perdidor/Arduino-MDB-UART/PCB/Full Schematics.png

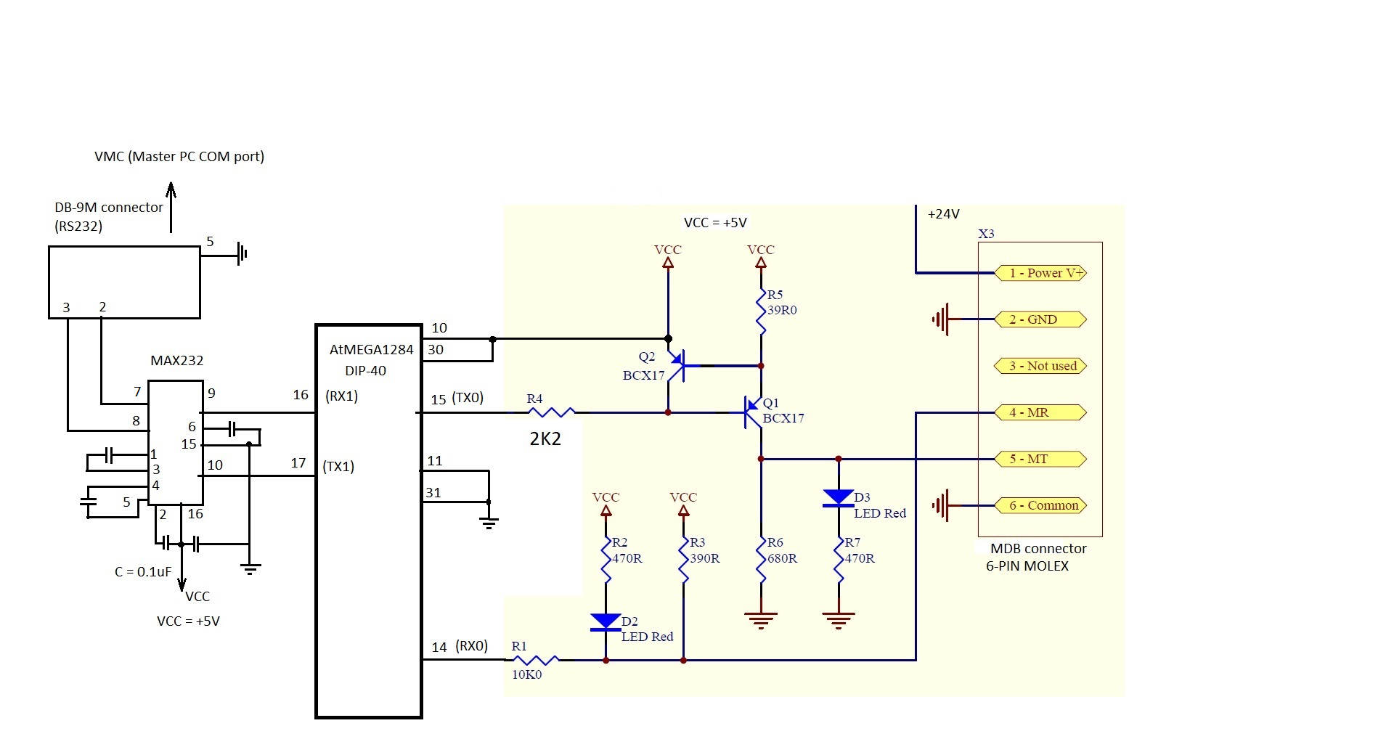
PCB/Full Schematics.png
