perdidor/Arduino-MDB-UART/Enclosure/cover.STL

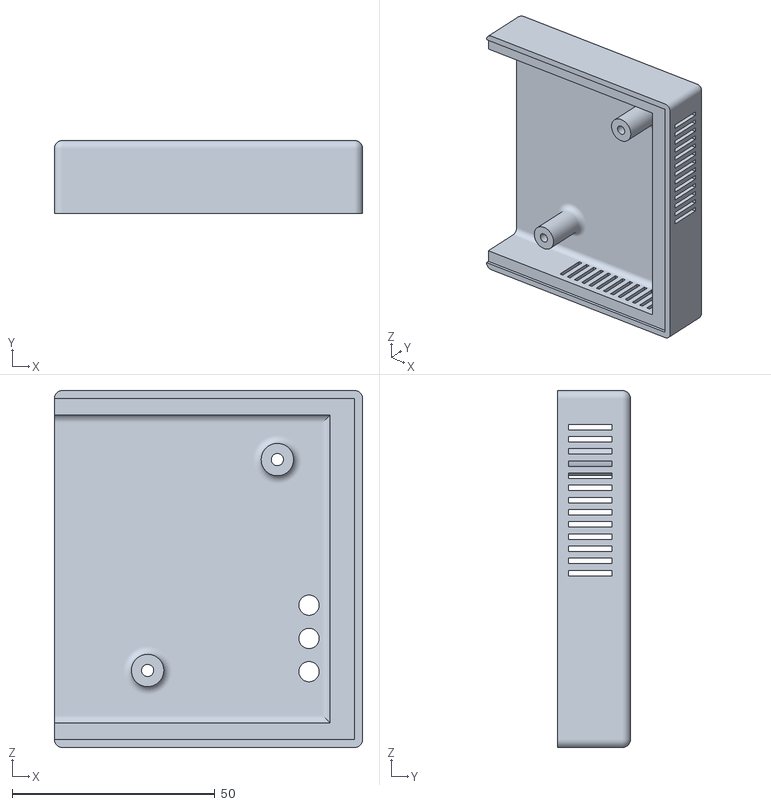
[picture p8: CAD file, 2018-10-23]
Enclosure/cover.STL
76.0 x 18.0 x 88.0
