perdidor/Arduino-MDB-UART/Enclosure/bottom.STL

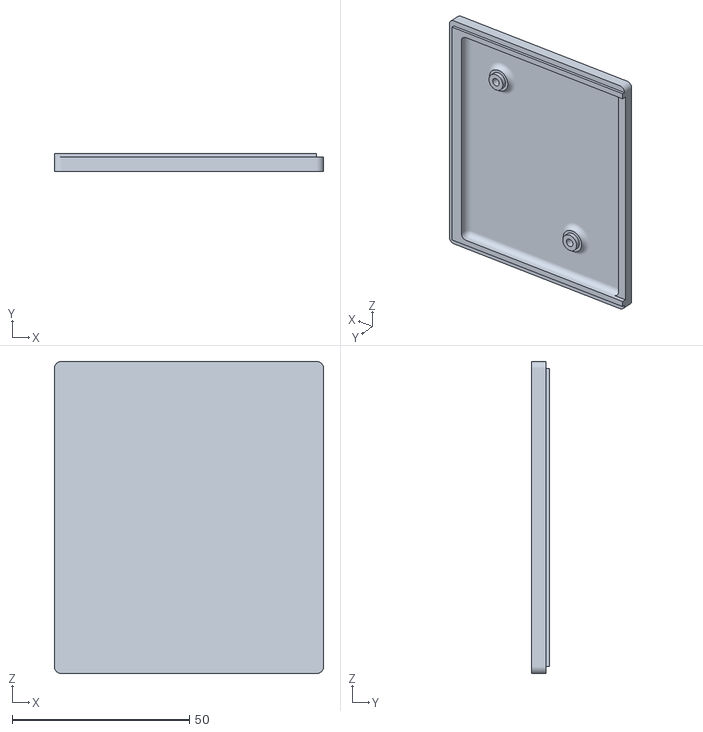
[picture p9: CAD file, 2018-10-23]
Enclosure/bottom.STL
76.0 x 5.00 x 88.0
