perdidor/Arduino-MDB-UART/Enclosure/assembly2.JPG

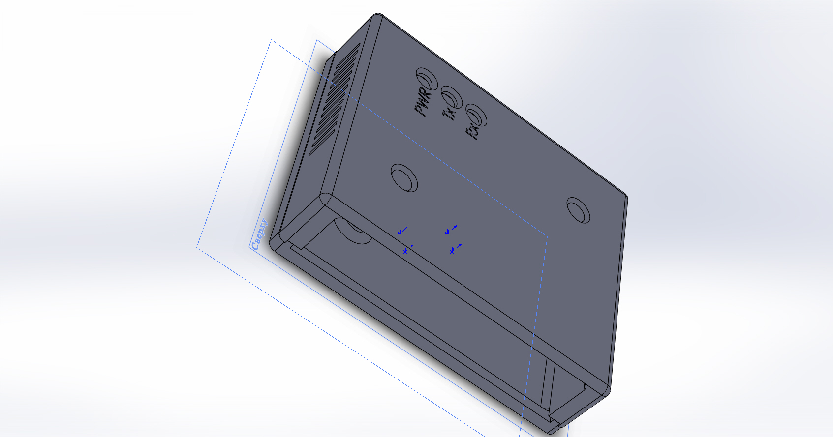
Enclosure/assembly2.JPG
