perdidor/Arduino-MDB-UART/Enclosure/assembly3.JPG

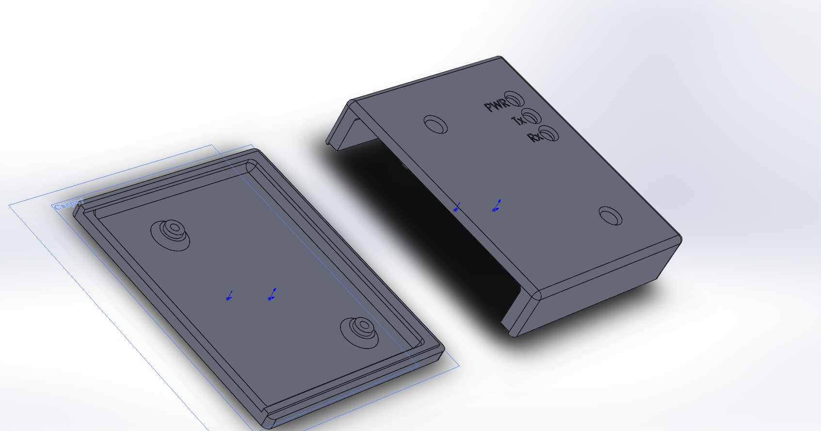
Enclosure/assembly3.JPG
