perdidor/Arduino-MDB-UART/Enclosure/assembly4.JPG

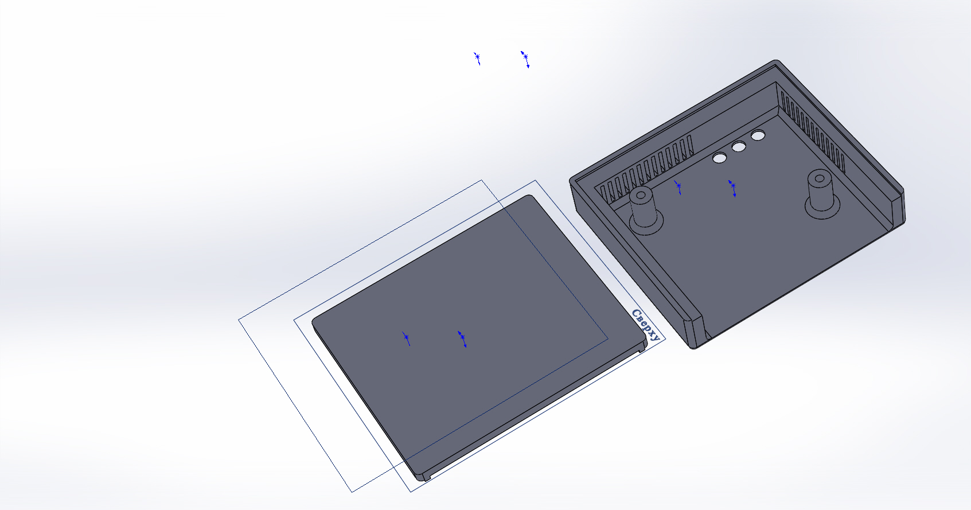
Enclosure/assembly4.JPG
