perdidor/Arduino-MDB-UART/Enclosure/assembly5.JPG

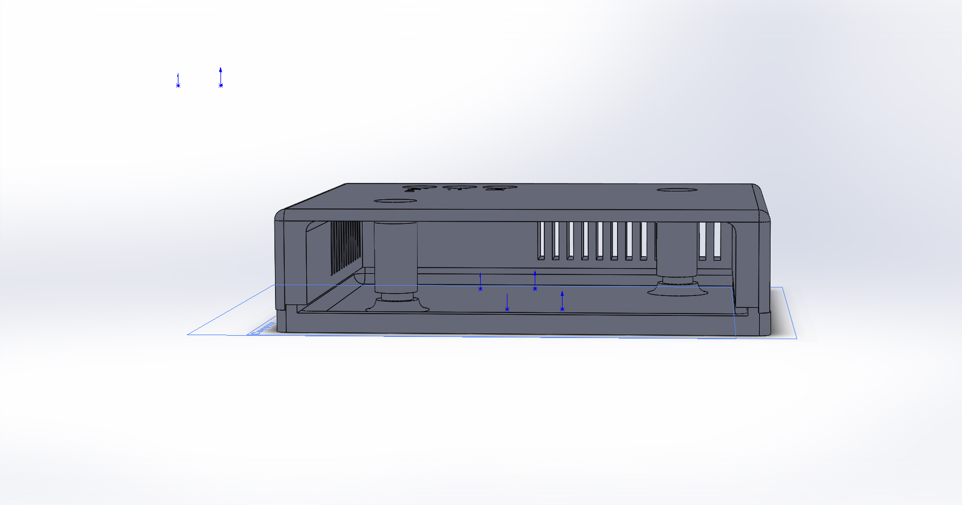
Enclosure/assembly5.JPG
