perdidor/Arduino-MDB-UART/(threads)

Thread 1 (2018-05-11):

Firmware: Not implemented "NAK" and "RET" responses

perdidor, 2018-05-11:
see "Commands, Repetition, ACK, NAK" section of MDB 4.2

perdidor, 2019-03-31:
[End of work notice](https://github.com/perdidor/Arduino-MDB-UART/issues/10)

Closed 2019-10-24.

Thread 2 (2018-10-19):

Where can I found source for serial1 library?

achest, 2018-10-19:
Hello!

/home/.../Arduino-MDB-UART/MDB_UART_Master/MDB_UART_Master.ino: In function 'void EXT_UART_Setup()':
MDB_UART_Master:75:3: error: 'Serial1' was not declared in this scope
   Serial1.begin(9600);

I need source Code for Serial1 class. Where can i found it?

ESP8266 /Wemos. Probably I need other lib than for arduino.

Many thanks,

Bestregards,

achest

perdidor, 2018-10-23:
Hello.
Your board has only one hardware UART (as per datasheet) called Serial0 (or just Serial). You can try software UART library like this: https://github.com/plerup/espsoftwareserial

Closed 2018-10-24.

Thread 3 (2018-10-31):

Communication via USB

lvlisael, 2018-10-31:
Is it possible to avoid the DB9 part using Serial1 to communicate with the mdb device and Serial0 (usb serial) to com with PC?

lvlisael, 2018-10-31:
I think it is possible, but still getting a coms error message on the coin changer

perdidor, 2018-10-31:
There are two ways to deliver data to master PC using USB:
1. Not changing implemented PCB design. Use USB-UART (FT232 or CP210x based) adapter and connect it to rx/tx/gnd socket in the bottom of the board
2. Change PCB design: remove MAX232 chip and DB9M connector, place FT232-like chip (only SMD design available afaik) and USB connector.

Closed 2018-10-31.

Thread 6 (2019-03-10):

How to make connections?

ertankucukoglu, 2019-03-10:
Hello,

Thanks for sharing your work. It is indeed valuable. I am trying to make MDB-RS232 communication. I have not worked with MDB protocol or vending machines before. Now, I must learn how to do that. I am still waiting vending machine parts to be delivered myself for my internal testings. I do not know what brand and model of a machine I need to work, yet.

My very much newbie questions are:
1- Do I need arduino to use your card? I cannot be sure by looking at information available. I cannot see clearly from the video. However, github name implies this is for arduino and there are some arduino codes, too.
2- I do not see any code for atmega1284 itself. Some people said to me "it is a programmable one. I need to have my code and upload that on that chip itself." I want to say that I am no electronic or electrician at all. I just want to be clarify that chip itself need to be programmed or not.
3- So far, I could not find any AtMEGA1284P-PU chip in my region. I can buy ATMEGA1284P-AU chip. Is that "AU" suffix chip can be used for that project?

Thanks & regards,
Ertan

perdidor, 2019-03-11:
1. Arduino is common name for evaluation boards, based on variable 8bit AtMega chips. Also, it's a whole ecosystem, including IDE for software developing and fast growing community (see arduino.org). So, do not think at this stage, just do what written in readme EXACTLY.
2. Code for AtMega1284 located in file MDB_UART_Master.ino . Open it within Arduino IDE and you'll see source text. Programming "bare" chip is not so simple as programming Arduino board with USB connector, but you'll have to do it. Just google for "arduino nano as ISP", "atmega1284 bare upload". And yes, you; need Arduino Nano V3 board for this. You can find ISP connector on board (MOSI, MISO, SCK, RESET, GND)
3. Atmega1284P-PU selected for this project as it has DIP (through-hole) design, as whole board components. All of Atmega chips having 2 or more hardware UARTs will work identical, regardless of chip package design, so you can use any.

Closed 2019-03-11.

Thread 7 (2019-03-11):

Min controller flash memory size

ertankucukoglu, 2019-03-11:
Hello,

What is minimum memory requirement for that setup? Used controller seemingly have 128kB flash memory.

Even that project is a low cost one. I am trying to figure a solution for a lower cost requirement project. Thinking of reducing memory on controller to get down its price. I read software uart is not suggested where timing is important.

Thanks & regards,
Ertan

perdidor, 2019-03-13:
Hello.
Compiled firmware is 5256 bytes, RAM required 618 bytes. It’s not so much the amount of memory on board as there are at least two hardware UART ports. As well as convenient chip packaging. The chip was chosen for the project on the basis of these parameters. You can choose any other chip with 2 or more hardware UARTs to upload this firmware.
Cheers.

Closed 2019-03-13.

Thread 8 (2019-03-27):

MDBLib: High level Cashless Device operations wrapper required

perdidor, 2019-03-27:
Section 7 of MDB 4.2

perdidor, 2019-03-31:
[End of work notice](https://github.com/perdidor/Arduino-MDB-UART/issues/10)

Closed 2019-10-24.

Thread 9 (2019-03-29):

FTL support absent

perdidor, 2019-03-29:
MDB 4.2 datasheet, Section 2.6 File Transport Layer.

perdidor, 2019-03-31:
[End of work notice](https://github.com/perdidor/Arduino-MDB-UART/issues/10)

Closed 2019-10-24.

Thread 10 (2019-03-31):

End of public work notice

perdidor, 2019-03-31:
The device is currently a simple UART level converter with minimal functions for processing incoming data from MDB. Despite this, the device is quite stable and can be used (and successfully used) as part of several dozen vending machines, where access to the extended functionality of devices supported by the bus is not required, frequent firmware upgrades and no contactless payments are not practiced. The MDBLib top-level library (current public version) supports devices like CoinChanger and BillValidator.
The implementation of FTL functionality and cashless payments requires significant changes to the controller's firmware code, because these modes of operation imply the presence of state-machine onboard for organizing real-time uninterruptible information exchange between the VMC, the cashless device and the converter. You will also need to refine the top-level library to support new adapter features.
In addition to software development, PCB rework will be required to ensure more stable operation and reduce the cost of the assembled board to 10USD max.
Planned time required on the development is more than 150 hours of my personal time, which I simply do not have when it comes to a hobby.
**Considering all the above, the work on the current public project is terminated.** Bugs will be fixed as they are found (as available time).
Work on advanced functionality (FTL, Cashless operations, support for NACK \ RET etc.) is already underway in private mode. For obvious reasons, the result of this work will not be public. Contact for any questions gfr20141201@gmail.com

Cheers.

Closed 2019-10-24.

Thread 11 (2020-07-29):

PCB rev2a - project file

djspoko, 2020-07-29:
Is it possible to add PCB rev2a project file? I have problem with gerber files. I tried to upload files to the factory but a lot of paths have shortcuts in their system.

perdidor, 2020-07-30:
zip archive contains all required files, open chat with support or send it directly to support email - see on factory site. Source files are not publicly available see src folder.

Closed 2020-07-30.

Thread 12 (2022-03-30):

Whats the purpose of "MDB_Master.pdf" ?

ottelo9, 2022-03-30:
I checked your pcb folder and saw the MDB_Master schematic. Only with a MAX232. Is this schematic for a simple RS232-MDB Converter cable?

I ask because I want to program my coin acceptor with the manufacturer software (called wheasy) and via the MDB connection. So I need a simple and dump converter circuit that converts my RS232 from PC to 9Bit MDB. Its a EM 800.13 v5 "Münzprüfer" from wh berlin.

perdidor, 2022-04-01:
if you mean burn firmware by "program coin acceptor" - this repository does not meet your needs.
if you want to control MDB coin acceptor/changer or bill acceptor - read main page of this repo.
Cheers.

perdidor, 2022-04-01:
MDB_Master schematic file was used as reference while developing this adapter

Closed 2022-04-02.

Thread 14 (2024-09-23):

CIRCUIT MDB SLAVE AND HOW TO USE IT ON ARDUINO MEGA

tomeroto, 2024-09-23:
Hi, can you give me the good circuit to making MDB SLAVE as Bill Acceptor?
And also, im not familiar on C (AVR), how to make the source codes to run in Arduino IDE.

thanks.

perdidor, 2024-09-24:
hello. This kind of service available commercially.

Closed 2024-09-24.

Thread 15 (2025-04-05):

RaspberryVending

improvingsasha, 2025-04-05:
Здравствуйте. Простите, что задаю вопрос не в соответствующей теме, но там этого сделать невозможно.
Установил на raspberry pi 3b+ windows iot версии 10.0.16299.15. Проект в visual studio компилирую методом release. Но при попытке установки через web интерфейс, в win iot возникает ошибка связанная с отсутствием Microsoft.NET.Native.Runtime.2.2.27328.0 или более свежей. Данный пакет не удалось найти в сети для архитектуры arm. Удалось найти только Microsoft.NET.Native.Runtime.2.2, которая успешно устанавливается. Я правильно понимаю, что при компиляции типа release все необходимые библиотеки должны включаться в пакет appx? Тогда почему не работает? Может есть необходимая версия .NET.Native... или более свежий образ win iot с интегрированным пакетом Net.Native? Как решить эту проблему? Что я не так делаю?
Буду очень благодарен если подскажете, что можно сделать. Готов отблагодарить. Если здесь невозможно обсуждать данную тему, можем по почте improvingsasha@inbox.ru или по телефону обсудить +79181135628.
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

Closed 2025-04-05.
