perdidor/Arduino-MDB-UART/PCB/MDB_Master.pdf

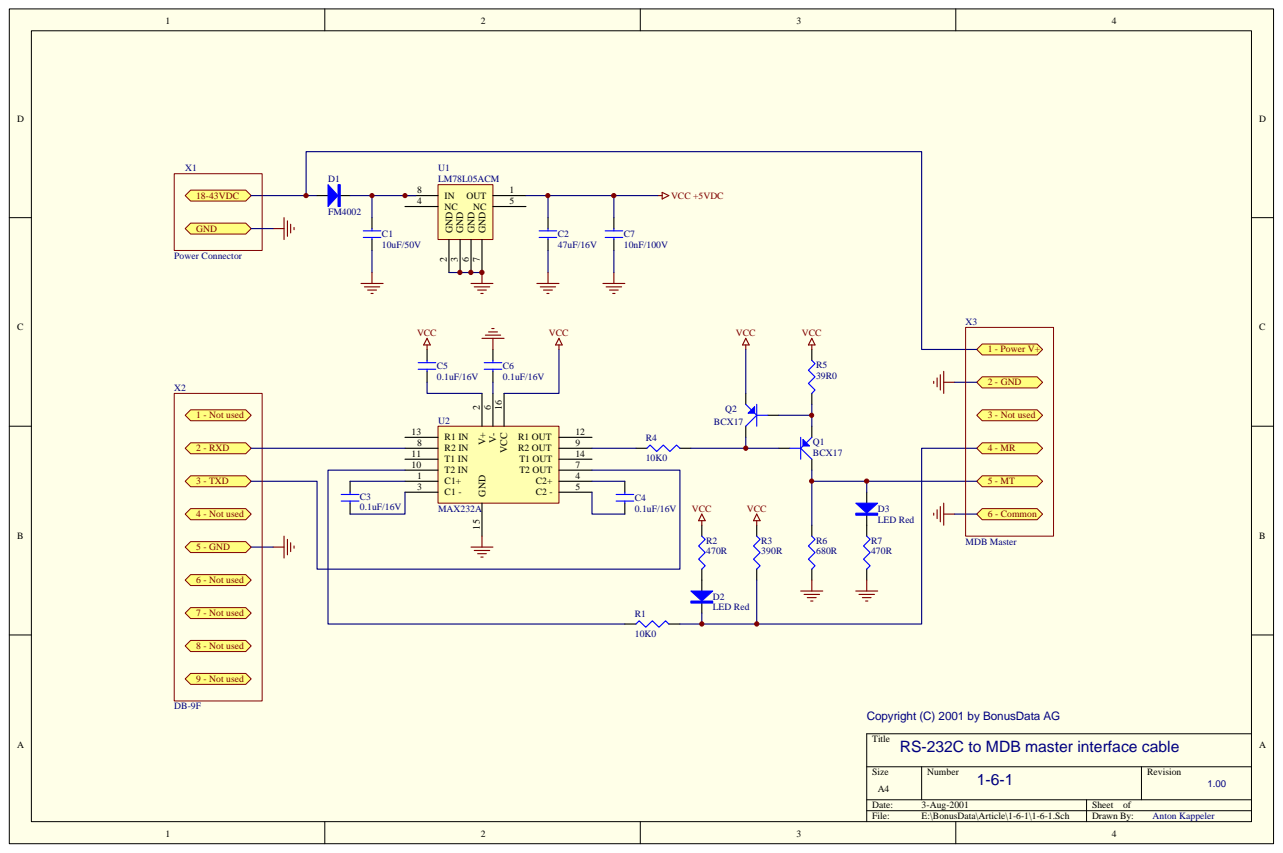
[picture p18: page 1]

Copyright (C) 2001 by BonusData AG
RS-232C to MDB master interface cable
