perdidor/Arduino-MDB-UART/(list of files, drawings)

Other design files:
PCB/mdb-rs232.lay6
PCB/MDB_MASTER_rev2a.lay6
