perdidor/Arduino-MDB-UART/(commit log)

2018-03-25 source and schematic added
2018-04-26 Full schematics added as requested.
2018-10-23 PCB design added
    [mdb-rs232.lay6]
2018-10-23 UART socket added
    [mdb-rs232.lay6]
2018-10-23 minor PCB improvements
2018-10-23 minor PCB improvement
2018-10-23 PCB improvement
    [mdb-rs232.lay6]
2018-10-23 PCB layout image added
2018-10-23 Enclosure 3D files added
    [bottom.STL, cover.STL]
2018-10-23 minor improvement
    [cover.STL]
2018-10-23 cooling holes added
    [cover.STL]
2018-10-23 minor enclosure improvement
    [cover.STL]
2018-10-23 PCB update for enclosure
    [mdb-rs232.lay6]
2018-10-23 PCB update
2018-10-24 update PCB photo
2018-10-24 PCB layout update
2018-10-25 добавлена русская версия описания
2018-10-25 Обновлено русское описание
2018-10-25 обновление русского описания
2019-03-26 Folders reorder
    [mdb-rs232.lay6]
2019-08-29 MDB Master PCB gerber RTM package added
    an advanced version of MDB master board from here:
    https://www.mdbstuff.com
2019-08-29 PCB rev2a render added
2019-08-29 Readme update
    PCB design fixed, render picture updated
2019-08-29 Rx LED polarity fixed
    [mdb-rs232.lay6]
2019-09-02 connectors added
2019-10-28 Arduino Mega firmware added
    ATmega2560@16MHz support
2020-02-27 ready-to-use device pic added
2020-11-19 atmega644p 16MHz fuses pic added
2023-10-11 rev2a PCB source added
    [MDB_MASTER_rev2a.lay6]
